WolfTronixSD/SeasonHouse/sd-card/CREDITS.md

# Sound credits

Every file in `01/` to `05/` and in `simulator/sounds/sim/` is built by
`tools/soundpack/build.py` from the sources below, then mixed, pitched,
reverbed and levelled. Music melodies are public-domain tunes (J. S. Bach,
Toccata and Fugue in D minor; J. Pierpont, Jingle Bells) or written for this
project.

## Recordings: Sonic Pi sample library (CC0 1.0, public domain)

From <https://github.com/sonic-pi-net/sonic-pi/tree/main/etc/samples>, originally from freesound.org and placed in the public domain:
`ambi_dark_woosh`, `ambi_haunted_hum`, `bd_haus`, `drum_cymbal_closed`, `drum_heavy_kick`, `drum_tom_lo_hard`, `drum_tom_lo_soft`, `elec_tick`, `hat_cab`, `misc_cineboom`, `misc_crow`, `perc_door`, `perc_impact1`, `perc_snap`, `perc_snap2`, `sn_dolf`.
No attribution needed; listed as thanks.

## Monster sounds: Freedoom (BSD 3-clause)

`dsbgdth1`, `dsbspact`, `dsdmact`, `dspdiehi`, `dsspisit` from <https://github.com/freedoom/freedoom/tree/master/sounds>.

```
Copyright © 2001-2024
Contributors to the Freedoom project.  All rights reserved.

Redistribution and use in source and binary forms, with or without
modification, are permitted provided that the following conditions are
met:

  * Redistributions of source code must retain the above copyright
    notice, this list of conditions and the following disclaimer.
  * Redistributions in binary form must reproduce the above copyright
    notice, this list of conditions and the following disclaimer in the
    documentation and/or other materials provided with the distribution.
  * Neither the name of the Freedoom project nor the names of its
    contributors may be used to endorse or promote products derived from
    this software without specific prior written permission.

THIS SOFTWARE IS PROVIDED BY THE COPYRIGHT HOLDERS AND CONTRIBUTORS “AS
IS” AND ANY EXPRESS OR IMPLIED WARRANTIES, INCLUDING, BUT NOT LIMITED
TO, THE IMPLIED WARRANTIES OF MERCHANTABILITY AND FITNESS FOR A
PARTICULAR PURPOSE ARE DISCLAIMED. IN NO EVENT SHALL THE COPYRIGHT OWNER
OR CONTRIBUTORS BE LIABLE FOR ANY DIRECT, INDIRECT, INCIDENTAL, SPECIAL,
EXEMPLARY, OR CONSEQUENTIAL DAMAGES (INCLUDING, BUT NOT LIMITED TO,
PROCUREMENT OF SUBSTITUTE GOODS OR SERVICES; LOSS OF USE, DATA, OR
PROFITS; OR BUSINESS INTERRUPTION) HOWEVER CAUSED AND ON ANY THEORY OF
LIABILITY, WHETHER IN CONTRACT, STRICT LIABILITY, OR TORT (INCLUDING
NEGLIGENCE OR OTHERWISE) ARISING IN ANY WAY OUT OF THE USE OF THIS
SOFTWARE, EVEN IF ADVISED OF THE POSSIBILITY OF SUCH DAMAGE.
```

For a list of contributors to the Freedoom project, see its `CREDITS` file.

## Voices: Kokoro TTS (Apache 2.0)

Spoken with the Kokoro-82M model (<https://huggingface.co/hexgrad/Kokoro-82M>, Apache License 2.0) through `kokoro-onnx` (<https://github.com/thewh1teagle/kokoro-onnx>, MIT). Voices used: `af_bella`, `af_heart`, `af_jessica`, `af_nicole`, `af_sky`, `am_adam`, `am_fenrir`, `am_michael`, `am_onyx`, `am_puck`, `am_santa`, `bm_george`.

## Synthesised in the build script

Plucked strings, bells, organ, bass, sleigh bells, wind, boings, creaks, the honk, crunches, squirrel chatter, ice crackle and the heartbeat timing.
