WolfTronixSD/SeasonHouse/hardware/print/seasonhouse_spider.3mf

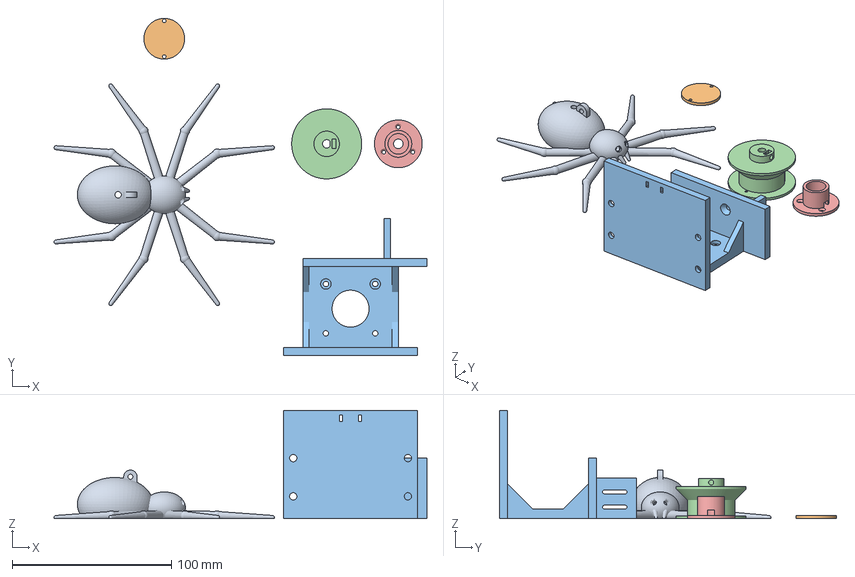
[picture p1: CAD file, 2026-11-02]
hardware/print/seasonhouse_spider.3mf
234.2 x 211.8 x 68.0 mm
spider_body
spider_battery_lid
winch_bracket
winch_spool
slipring_cup
