WolfTronixSD/SeasonHouse/hardware/print/spider_body.stl

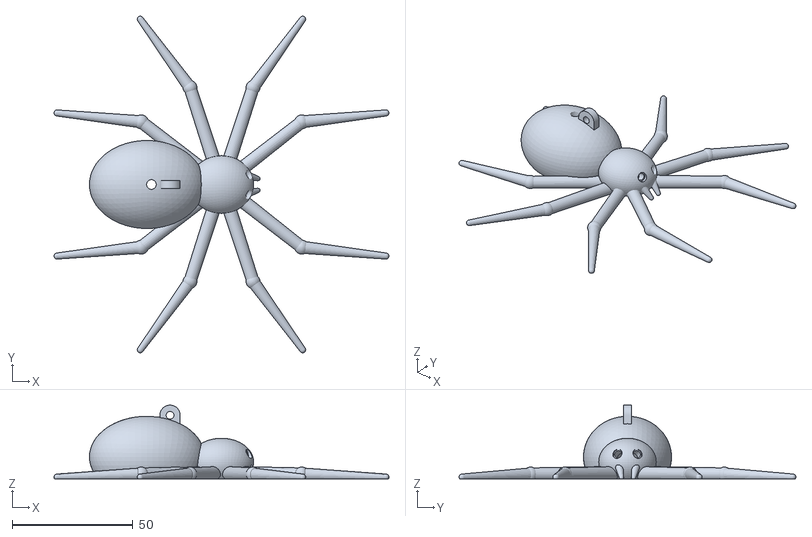
[picture p2: CAD file, 2026-11-02]
hardware/print/spider_body.stl
138.5 x 139.2 x 30.5
