WolfTronixSD/SeasonHouse/hardware/print/spider_battery_lid.stl

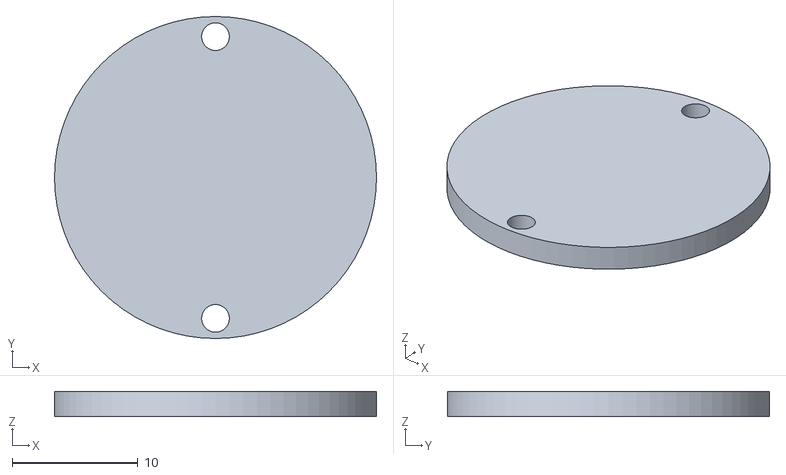
[picture p3: CAD file, 2026-11-02]
hardware/print/spider_battery_lid.stl
25.6 x 25.6 x 2.00
