WolfTronixSD/SeasonHouse/hardware/print/slipring_cup.stl

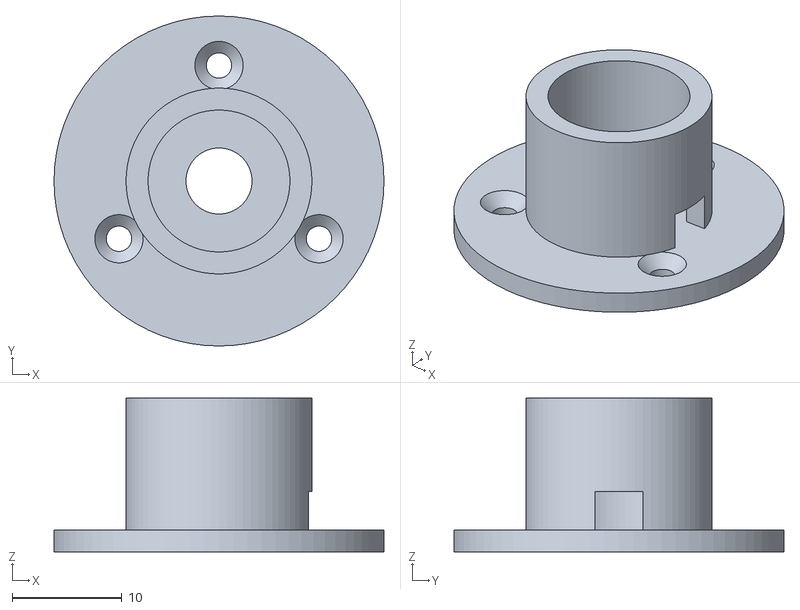
[picture p4: CAD file, 2026-11-02]
hardware/print/slipring_cup.stl
30.0 x 30.0 x 14.0
