WolfTronixSD/SeasonHouse/hardware/print/winch_spool.stl

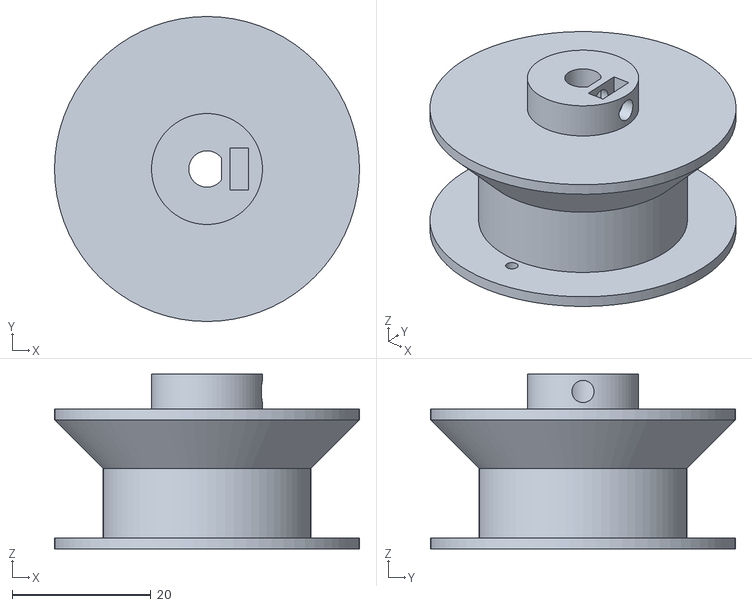
[picture p5: CAD file, 2026-11-02]
hardware/print/winch_spool.stl
44.0 x 44.0 x 25.2
