WolfTronixSD/SeasonHouse/hardware/print/winch_bracket.stl

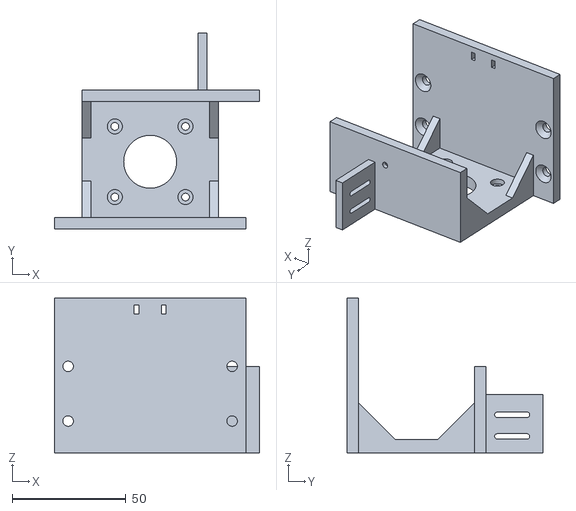
[picture p6: CAD file, 2026-11-02]
hardware/print/winch_bracket.stl
90.0 x 86.0 x 68.0
