WolfTronixSD/SeasonHouse/(commit log)

2026-10-18 Add Corner Spider prop: ESP32 firmware, web control page, WLED, docs
    Stepper winch drop/raise with top homing switch, LED eyes, piezo chitter,
    DFPlayer sound, PIR and party-mode triggers, six scripted shows, and a
    control page served from the ESP32 (Wi-Fi or its own hotspot). Includes
    wiring guide, prop idea list with a $100 shopping plan, and a CI build.
    Claude-Session: https://claude.ai/code/session_01KF1Pz2vi3KYw4oaKnojq89
2026-10-18 Add season mode and a browser simulator
    The ceiling prop now has five seasons (Halloween spider, Christmas Santa,
    Easter bunny, Fall squirrel, Winter yeti), each with its own shows, SD-card
    sound folder and WLED presets, chosen from the control page and saved in
    flash. simulator/index.html runs the same show scripts in a virtual room;
    tools/gen_seasons.mjs generates the firmware's seasons.h from it, and CI
    checks the two stay in sync.
    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
2026-10-18 Port the prop firmware to MicroPython with wireless updates
    Replaces the Arduino/C++ firmware. Same pins, API, seasons and shows.
    The stepper STEP pin is driven by hardware PWM ramped by a 10 ms timer, and
    the position re-zeroes on the top switch after every raise. New files can be
    uploaded from the control page or tools/ota_push.py; .py files are
    test-compiled before they are installed, and a self-contained recovery page
    starts if the prop code crashes at boot. Adds PC tests with fake hardware
    and a CI job that compiles everything with mpy-cross.
    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
    [app.py, compat.py, config.py, dfplayer.py, fx.py, main.py, motion.py, net.py]
2026-10-18 Make the simulator look and sound like the real room
    Lit room with wallpaper, window, door and portrait; seasonal decor and
    particles (fog, snow, leaves, butterflies, confetti and a disco ball);
    light map with glowing eyes, LEDs and candles; shadow, camera shake and
    lightning flashes. Sounds are now formant voices, music per season,
    thunder and room tone through reverb. Motion maths matches the firmware's
    fixed Profile.
    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
2026-10-18 Real sound pack, visible guests and more simulator effects
    - sd-card/01..05: 40 ready-to-copy MP3s built from CC0 Sonic Pi
    recordings, Freedoom monster sounds and Kokoro TTS voice lines, plus
    five dance tracks; credits and licences in sd-card/CREDITS.md
    - tools/soundpack/build.py rebuilds the pack
    - Simulator plays the real MP3s one at a time like the DFPlayer, with
    recorded room ambience, thunder, door and guest reactions
    - Guests are lit by the hall light, dressed per season, and react
    - New effects: lightning bolts, bats, wall shadow, eye beams, dust and
    snow bursts, fog push, scare pulse and frost
    Claude-Sessio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
2026-10-18 Add Lightning Window, Scream-o-Meter, Cauldron of Doom and Rat Express
    Four new props, each its own ESP32 with MicroPython firmware, a web
    control page and OTA updates, sharing the spider's modules. Adds their
    SD-card sounds, tests, docs, and all four to the simulator.
    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
2026-10-21 Add a bill of materials for all five props
    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
2026-11-02 Add printable winch bracket, spool and spider with 3 mm LED eyes
    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
    [spider_body.stl, winch_bracket.stl, winch_spool.stl]
2026-11-02 Stand the microswitch tab on the bed so the bracket prints without supports
    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
    [winch_bracket.stl]
2026-11-02 Clarify which side of the tab the switch goes on
    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
2026-11-02 Let the spider's fang tips reach the bed so nothing starts in mid-air
    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
    [spider_body.stl]
2026-11-02 Make the printed spider 30% bigger, keeping the LED and line holes their real size
    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
    [spider_body.stl]
2026-11-02 Make the printed spider 30% of the first design, with a head that still fits 3 mm LEDs
    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
    [spider_body.stl]
2026-11-02 Bigger coin-cell spider, slip ring cup and assembly guide
    Spider is now 138 mm with a CR2032 pocket and screw-on lid. New
    slipring_cup.stl mounts a 12.5 mm slip ring on the spool; the spool
    gets M2 pilot holes and a wire hole, the bracket zip-tie slots.
    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
    [slipring_cup.stl, spider_battery_lid.stl, spider_body.stl, winch_bracket.stl, winch_spool.stl]
2026-11-02 Spider: no flat overhangs in the battery recess or hollow head
    The lid recess now steps to the cell pocket at 45° instead of a flat
    ledge, and the hollow head has a 45° cone roof, which clears Bambu
    Studio's floating-cantilever warning.
    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
    [spider_body.stl]
2026-11-02 Add a Bambu Studio project with per-part print settings
    seasonhouse_spider.3mf puts all five parts on one plate with walls,
    infill and brim set per part; make_3mf.py rebuilds it from the STLs.
    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
    [seasonhouse_spider.3mf]
2026-11-02 Spider: flat feet on every leg, lid screws clear of the edge
    Legs and fangs now sink 0.5 mm into the bed so each has a flat strip on
    the first layer (Bambu flagged them as floating). The lid's screw holes
    moved in so they no longer cut through its rim, and the 3mf no longer
    claims to be a Bambu project, which made Bambu reject its config.
    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
    [seasonhouse_spider.3mf, spider_battery_lid.stl, spider_body.stl]
2026-11-02 3mf: include full X2D project settings so Bambu keeps per-part settings
    Bambu Studio rejects a project without project_settings.config and then
    drops the per-part settings too. bambu_x2d_project_settings.json is the
    X2D 0.4 / 0.20mm Standard / Bambu PLA Basic profile chain flattened from
    Bambu Studio's own profile files.
    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
    [seasonhouse_spider.3mf]
2026-11-02 Lid: drop the thumbnail notch so it is a plain flat plate
    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
    [seasonhouse_spider.3mf, spider_battery_lid.stl]
2026-11-02 3mf: share vertices so each part is a closed mesh
    The meshes were loose STL triangles, so Bambu Studio found empty layers
    and floating regions in parts that are solid.
    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
    [seasonhouse_spider.3mf]
2026-11-02 Spider: 45° skirts under the body, head and legs
    Every outside surface now slopes at 45° or steeper, so nothing bulges out
    over thin air near the bed.
    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
    [seasonhouse_spider.3mf, spider_body.stl]
2026-11-02 Spider: pointed battery-pocket roof with a screw as the + contact
    The flat 21 mm pocket roof was the floating cantilever Bambu reported.
    It is now a 45° cone; an M2 x 12 pan-head screw driven into its top is
    the + contact.
    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
    [seasonhouse_spider.3mf, spider_body.stl]
